DabeerAzeez/Team22-5P06-Capstone/src/assets/check-circle.png

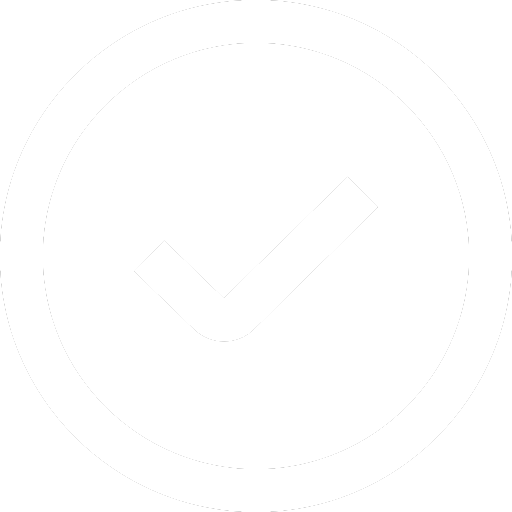
src/assets/check-circle.png
