DabeerAzeez/Team22-5P06-Capstone/src/assets/eraser_white.png

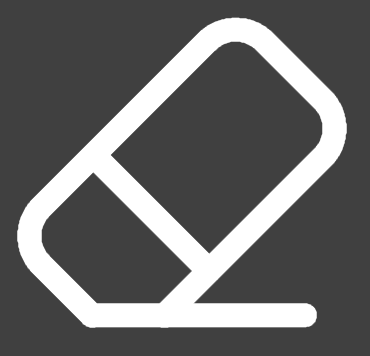
src/assets/eraser_white.png
