DabeerAzeez/Team22-5P06-Capstone/src/assets/export.png

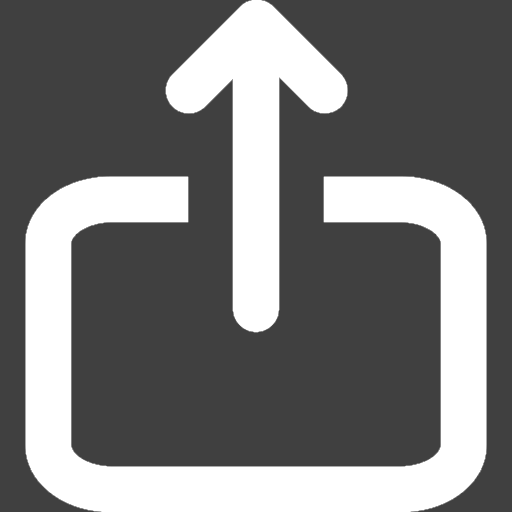
src/assets/export.png
