DabeerAzeez/Team22-5P06-Capstone/src/assets/play-button-arrowhead.png

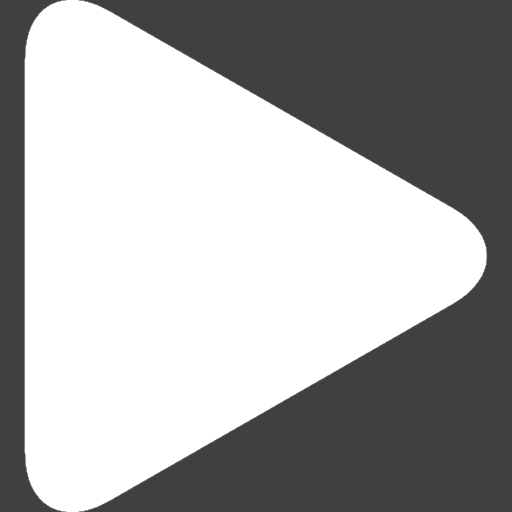
src/assets/play-button-arrowhead.png
