DabeerAzeez/Team22-5P06-Capstone/docs/CCTA BOM.xlsx

Part Number | Description | Type | Quantity | Unit | Material | Supplier | Cost per Unit (CAD) | Total Cost (CAD) | Source | Notes
1 | 12V Diaphragm Water Pump | Mechanical | 1 | Each | Misc. | Bayite | 64.68 | 64.68 | Link (https://www.amazon.ca/gp/product/B07V9G4S41?ie=UTF8&psc=1)
2 | Kohree RV Water Pressure Regulator Valve | Mechanical | 1 | Each | Brass | Amazon | 39.99 | 39.99 | Link (https://www.amazon.ca/dp/B08TGQP7ZX?ref=ppx_yo2ov_dt_b_fed_asin_title&th=1)
3 | 3/8 NPTF Female Needle Valve | Mechanical | 1 | Each | Brass | McMaster Carr | 85.49 | 85.49 | Link (https://www.mcmaster.com/46425K13/)
4 | Right Atrium | Mechanical | 1 | Each | Resin | Boston Scientific | 0 | 0 |  | Price Unknown
5 | Left Atrium | Mechanical | 1 | Each | Resin | Boston Scientific | 0 | 0 |  | Price Unknown
6 | Heart Base | Mechanical | 1 | Each | Resin | Boston Scientific | 0 | 0 |  | Price Unknown
7 | 3/8" GREDIA Quick Connect Water Flow Sensor Food-Grade | Electrical | 2 | Each | Food Grade Plastic | Amazon | 14.99 | 29.98 | Link (https://www.amazon.ca/GREDIA-Food-Grade-Flowmeter-Counter-0-3-10L/dp/B07MY7H45V)
8 | Pressure Transducer | Electrical | 3 | Each | Misc. | Utah Medical | 15.86 | 47.58 | Link (http://www.utahmed.com/deltran.html)
9 | Continuous-Flex Soft Tygon PVC Tubing (3/8" ID) | Mechanical | 25 | ft | PVC Plastic | McMaster Carr | 4.36 | 109 | Link (https://www.mcmaster.com/5894K37/)
10 | Continuous-Flex Soft Tygon PVC Tubing (1/4" ID) | Mechanical | 2 | ft | PVC Plastic | McMaster Carr | 7.4 | 14.8 | Link (https://www.mcmaster.com/55485K74/)
11 | Rigid PVC Tubing (3/8" ID) | Mechanical | 25 | ft | PVC Plastic | McMaster Carr | 1.22 | 30.5 | Link (https://www.mcmaster.com/5233K65/)
12 | Reservoir | Mechanical | 1 | Each | Plastic | Dollarama | 2 | 2 | Link (https://dollarama.instacart.com/store/dollarama/products/25063811-snaptite-food-container-each)
13 | DC Power Supply Variable,30V 10A | Electrical | 1 | Each | Misc. | Sky Toppower | 76 | 76 | Link (https://www.amazon.ca/Adjustable-Switching-Regulated-Alligator-Spectrophotometer/dp/B07GCKHKC6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)
14 | Tuohy valve | Mechanical | 1 | Each | PC Silicone | Qosina | 18.98 | 18.98 | Link (https://www.qosina.com/tuohy-borst-adapter-barbed-11224?VariantID=Version_v-01)
15 | 3/8" NPT to 3/8" Barb | Mechanical | 2 | Each | Brass | McMaster Carr | 3.16 | 6.32 | Link (https://www.mcmaster.com/5346K19/)
16 | Garden Hose to 3/8" Barbed Fitting | Mechanical | 1 | Each | Brass | Amazon | 26.01 | 26.01 | Link (https://www.amazon.ca/dp/B0BX32C2GM?ref=ppx_yo2ov_dt_b_fed_asin_title&th=1)
17 | Barbed T Connector (3/8" to 1/4") | Mechanical | 3 | Each | PP Plastic | Qosina | 1.66 | 4.98 | Link (https://www.qosina.com/t-connector-reducer-barbed-natural-61204-1?VariantID=Version_v-01)
18 | Barbed y connector (3/8") | Mechanical | 2 | Each | PP Plastic | Qosina | 2.15 | 4.3 | Link (https://www.qosina.com/y-connector-barbed-natural-61310-3?VariantID=Version_v-01)
19 | 3/8" Hose ID Barb Thru-Bulk Bulkhead Fittings | Mechanical | 1 | Pack | Plastic | Patikil | 15.24 | 15.24 | Link (https://www.amazon.ca/PATIKIL-Thru-Bulk-Bulkhead-Fittings-Silicone/dp/B0DKCQTFPZ?th=1)
20 | Plastic Bottling Bucket Spigot tap Faucet | Mechanical | 1 | Pack | Plastic | Pera Store | 8 | 8 | Link (https://www.amazon.ca/Plastic-Bottling-Bucket-Spigot-Homebrew/dp/B0746GXTV1)
21 | Peg Board | Mechanical | 1 | Each | Wood | Home Depot | 16.94 | 16.94 | Link (https://www.homedepot.ca/product/alexandria-moulding-3-16-inch-x-24-inch-x-48-inch-pegboard-white-handy-panel/1000165172)
22 | Zip Ties | Mechanical | 1 | Pack | Plastic | Home Depot | 7.47 | 7.47 | Link (https://www.homedepot.ca/product/commercial-electric-8-inch-cable-ties-indoor-use-nylon-material-white-100-pack-/1000762523)
23 | Hose Clamps | Mechanical | 1 | Pack | Stainless Steel | Ouru | 20.99 | 20.99 | Link (https://www.amazon.ca/OURU-Stainless-Automotive-Mechanical-Applications/dp/B09ZQTSZ5L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)
24 | Female Luer Lock, Barbed 1/4" | Mechanical | 4 | Each | Nylon | Qosina | 0.241 | 0.964 | Link (https://www.qosina.com/female-luer-lock-barbed-white-11530?VariantID=Version_v-01)
25 | One way stopcock | Mechanical | 10 | Each | HDPE | Qosina | 1.36 | 13.6 | Link (https://www.qosina.com/female-luer-lock-barbed-white-11530?VariantID=Version_v-01)
26 | Control box | Mechanical | 1 | Each | Plastic | McMaster | 0 | 0 |  | 3D Printed
27 | Arduino | Electrical | 1 | Each | Misc. | Arduino | 45.92 | 45.92 | Link (https://store.arduino.cc/products/arduino-uno-rev3)
28 | Motor driver | Electrical | 1 | Pack | Misc. | Reland Sun | 27 | 27 | Link (https://www.amazon.ca/BTS7960-Power-Driver-Module-Current/dp/B0CRP2BMRJ?s=electronics)
29 | Solder-able Prototype Breadboard | Electrical | 1 | Each | Misc. | Gikfun | 15.8 | 15.8 | Link (https://www.amazon.ca/Gikfun-Solder-able-Breadboard-Arduino-Electronic/dp/B0778G64QZ?s=electronics)
30 | 5mm LED | Electrical | 1 | Pack | Misc. | Adafruit Industries | 8.43 | 8.43 | Link (https://www.amazon.ca/Gikfun-Assorted-Arduino-100pcs-EK8437/dp/B01ER728F6?s=electronics)
31 | Aviator Connectors | Electrical | 1 | Pack | Misc. | Hilitchi | 31.63 | 31.63 | Link (https://www.amazon.com/dp/B07F5B5LLX?th=1&language=en_US&currency=CAD)
32 | Banana Plugs | Electrical | 1 | Pack | Misc. | Walfront | 13.54 | 13.54 | Link (https://www.amazon.com/Amplifier-Terminal-Connector-Binding-Banana/dp/B07H699FQV)
33 | 22AWG Wire | Electrical | 1 | Spool | Misc. | Dkardu | 12.42 | 12.42 | Link (https://www.amazon.ca/DKARDU-Electrical-Conductor-Stranded-Flexible/dp/B09PH3DNTV?th=1)
34 | E stop | Electrical | 1 | Each | Misc. | RuoFend | 12 | 12 | Link (https://www.amazon.ca/RuoFeng-Mushroom-Emergency-Button-Switch/dp/B07HBN45Q9)
35 | USB printer cable | Electrical | 1 | Each | Misc. | Moswag | 9.59 | 9.59 | Link (https://www.amazon.ca/MOSWAG-Printer-Durable-Lexmark-Brother/dp/B08ZD279K2)
36 | M3-0.5x10mm socket cap screw (3-Pieces) | Mechanical | 4 | Each | Stainless Steel | Home Depot | 0.5625 | 2.25 | Link (https://www.homedepot.com/p/Everbilt-M3-0-5x10mm-Plain-Socket-Cap-Head-Internal-Hex-Drive-Cap-Screw-3-Pieces-864518/323372100)
37 | M2.5 x 0.45 mm Thread, 8 mm Long (50 Pack) | Mechanical | 50 | Each | Alloy Steel | McMaster Carr | 0.32 | 16 | Link (https://www.mcmaster.com/91290A102/)
38 | Heat inserts | Mechanical | 20 | Each | Brass | Spool3D | 0.15 | 3 | Link (https://spool3d.ca/m3-knurled-brass-threaded-insert/)
