DabeerAzeez/Team22-5P06-Capstone/docs/CCTA Operation Manual.docx

# CCTA Operation Manual

# Equipment Needed

Item | Purpose
CCTA Physical System
Laptop with MATLAB r2023a or later installed | To operate the CCTA
CCTA MATLAB App | To control the CCTA
Syringe with male luer lock fitting | Debubble pressure transducers for pressure testing

# Software Installation

1. Clone or download the GitHub repository
  a. Cloning is ideal, so that you can stay up to date with any future changes. You can use GitHub desktop to do so, or just Git. Otherwise, just download the files onto your computer.
2. Install MATLAB R2023b or later (https://www.mathworks.com/help/install/ug/install-products-with-internet-connection.html)
3. Install the Arduino IDE (https://www.arduino.cc/en/software/)
4. (Optional) open src/CCTA_Arduino/CCTA_Arduino.ino and re-upload the script onto the Arduino board.
  a. Important to do especially after any changes to the Arduino script.
5. Open src/CCTA.mlapp
  a. This will open MATLAB itself (which you can minimize, but do not close)
  b. As well as the actual application (a smaller window as seen below)

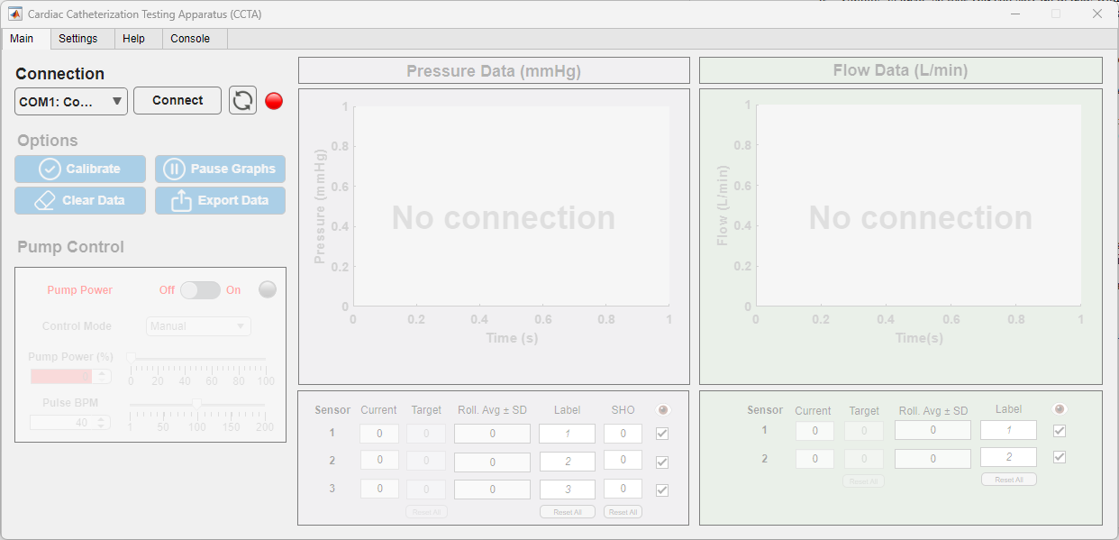
[picture p23: figure]

# System Operational Procedure

1. Set up the flow system
  a. Connect the pump inlet and outlet with 3/8” tubing
  b. Position system components (i.e. tubing, connectors, valves, heart model, flow meter(s), and pressure transducer(s)) at the desired test point locations within the system
  c. Fill reservoir with water (e.g. use a separate bucket and fill it up at a sink)
1. Set up the control box
  a. Connect the flow meter connectors to the ports on the control box:

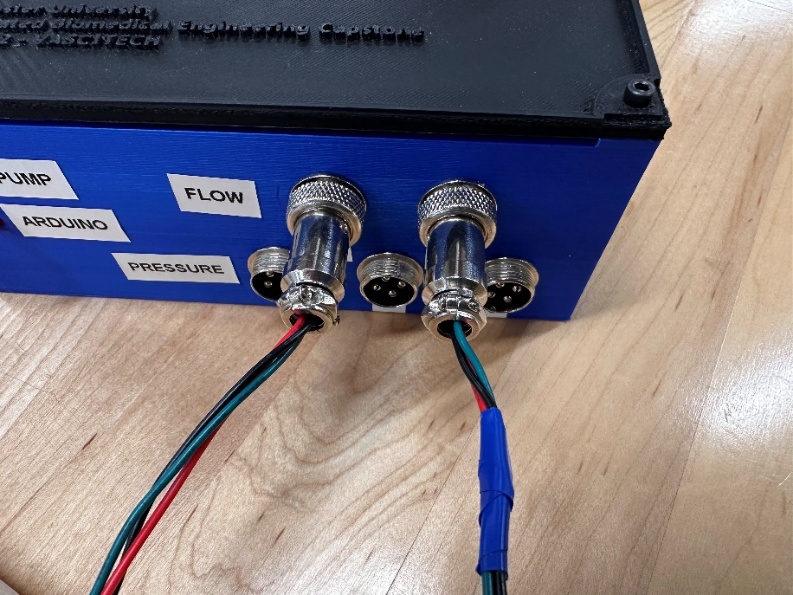
[picture p24: figure]

  b. Connect the pressure meter connectors to the ports on the control box:

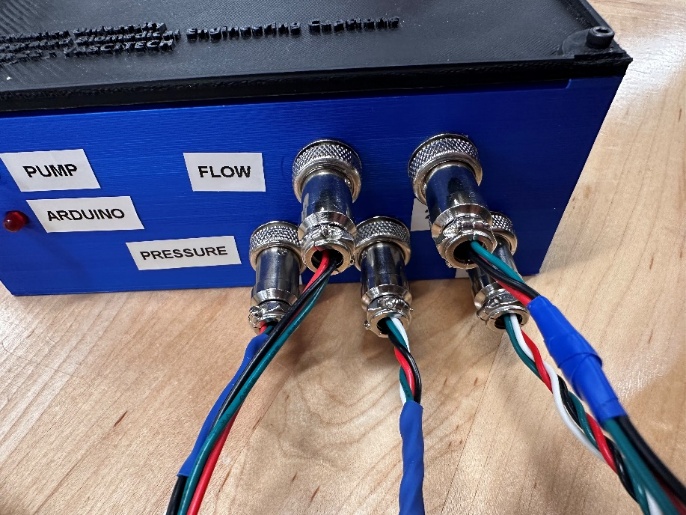
[picture p25: figure]

  c. Connect banana plugs between the power supply and the control box:

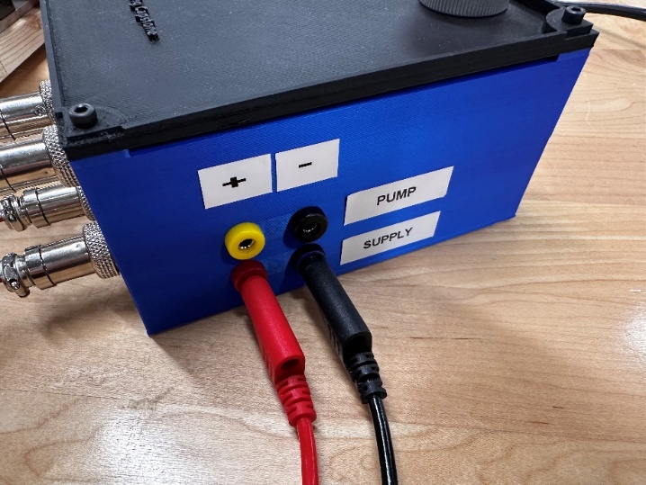
[picture p26: figure]

  d. Connect banana plugs between the control box and the pump:

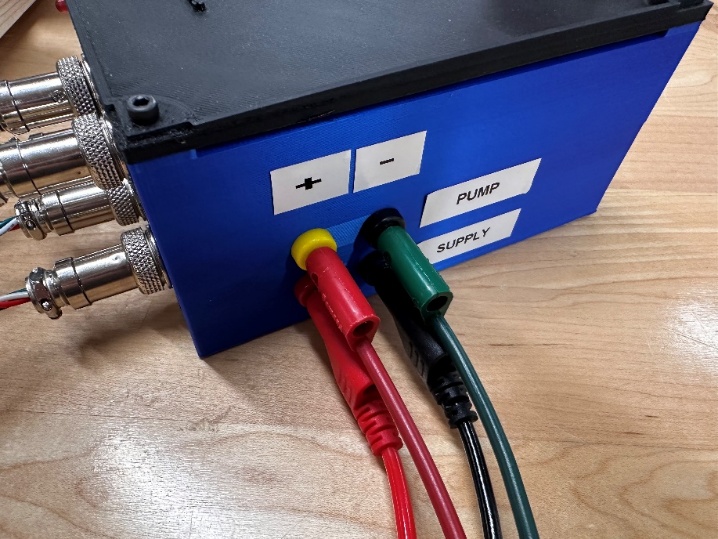
[picture p27: figure]

  e. Connect the user’s computer to the USB port on the control box and ensure the red LED on the control box lights to indicate successful connection:

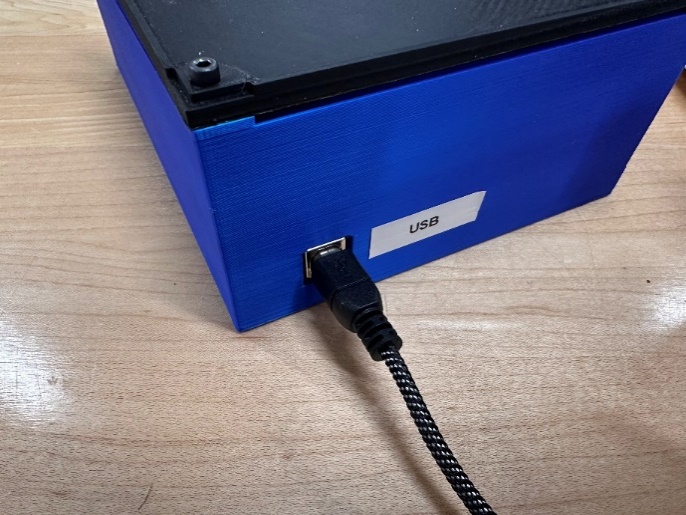
[picture p28: figure]

2. Start the system
  a. Turn on the power supply, set to 12 V and a 3.3 A
  b. Run the GUI in MATLAB (i.e. run the CCTA.mlapp file using MATLAB) and connect to the appropriate COM port (it should say “Arduino Uno” in the dropdown)
3. Test basic functionality of the GUI
  a. Confirm that baseline flow and pressure are being reported in the GUI (in the textboxes as well as the graphs)
    i. When the pump is off, flow values should be 0 and pressure values should be low (around 8-10 mmHg, corresponding to the static head offset in the system)
  b. After confirming basic GUI functionality and enabling pump power, you can select the Control Mode from the dropdown menu in the GUI. The system provides three modes:
    i. Manual (default)
    ii. Auto
    iii. Pulsatile

Use the dropdown menu (see below) to switch between modes as needed for your experiment:

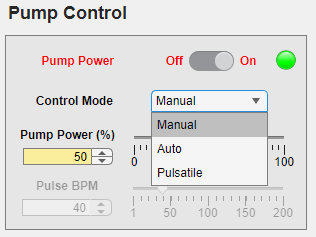
[picture p29: figure]

  4.1 Manual Mode (Default)

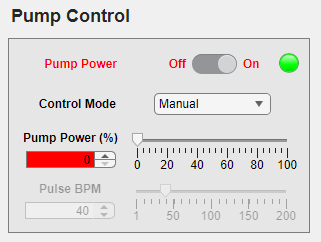
[picture p30: figure]

    - Enable pump power by toggling the slider to On.
    - Ensure the system is operating in Manual Mode (check the Control Mode dropdown).
    - Set an initial Pump Power (%) value (recommended to start at 50%) to confirm proper system function.
    - Confirm the blue LED on the control box lights up, indicating the pump is receiving power.
    - Adjust the Pump Power (%) slider or input box manually to increase or decrease the pump speed.
    - Verify that changes in pump power result in appropriate changes in flow rate and pressure on the GUI.
    - Confirm that other GUI elements behave as expected (hover over buttons for descriptions).
  4.2 Auto Mode

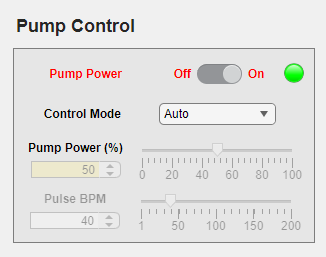
[picture p31: figure]

In Auto Mode, the system automatically adjusts pump power to maintain a specified target flow or pressure using PID control.
Steps to operate in Auto Mode:

- DO NOT select Auto Mode from the Control Mode dropdown (this will not work).
- Instead, enter your desired Target value in the box corresponding to a specific flow or pressure sensor.
- Press Enter to confirm. The Target box just chosen will highlight green, and the pump power slider and spinner will be slightly greyed out, indicating the system has accepted the target and is actively adjusting pump power.

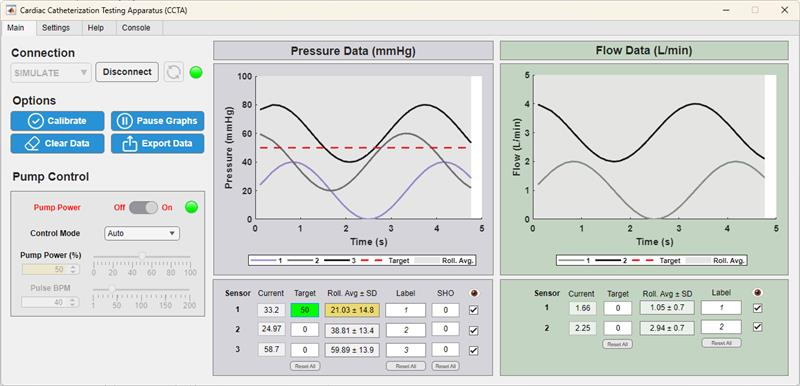
[picture p32: figure]

- Observe the Pump Power (%) value changing automatically as the system adjusts to reach the target.
- Wait for the system to stabilize at the setpoint before beginning any measurements or catheter testing.
  4.3 Pulsatile Mode

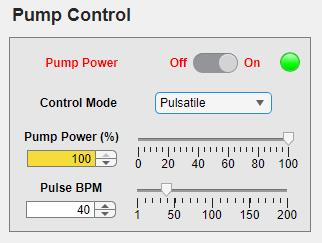
[picture p33: figure]

In Pulsatile Mode, the pump output follows a simple sinusoidal waveform designed to mimic physiological flow conditions, such as a heartbeat. This mode allows you to adjust two key parameters:

- Pump Power (%): Controls the amplitude of the pulses (i.e., the peak pump power during each pulse). Higher values increase the pulse strength.
- Pulse BPM (Beats Per Minute): Sets the frequency of the pulsatile waveform, determining how many pulses occur per minute.

Steps to operate in Pulsatile Mode:

- Select Pulsatile Mode from the Control Mode dropdown.
- Set the Pump Power (%) to determine the amplitude of each pulse (default 100%).
- Set the Pulse BPM value to define the pulse frequency (default 40 BPM).
- Observe the flow and pressure waveforms reflecting the pulsatile output in real-time on the GUI graphs.
- Adjust Pump Power (%) and Pulse BPM as needed to simulate desired physiological conditions.
4. Catheter testing (Flow Simulation)
  a. Open the needle valve to the silver line (fully open).

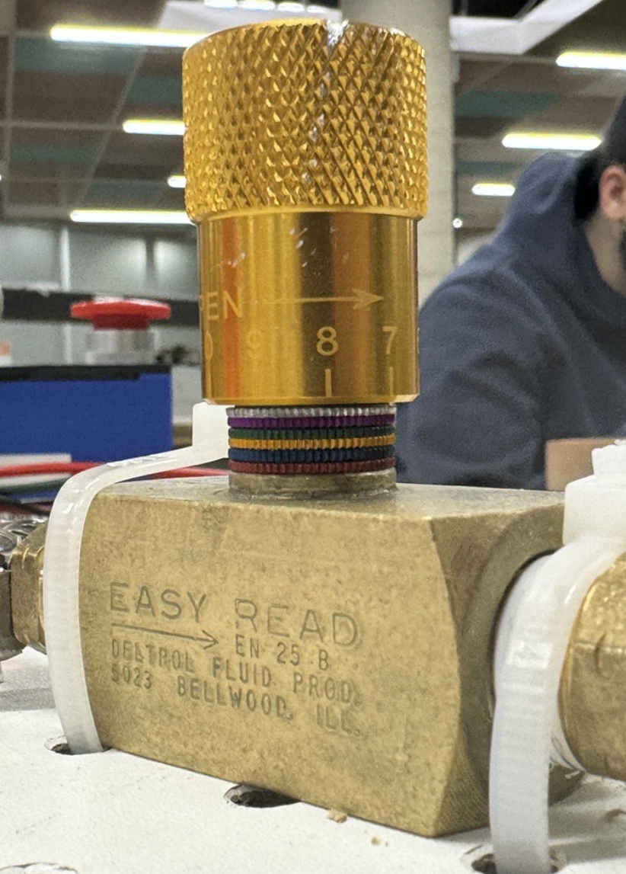
[picture p34: figure]

Silver Line

  b. Enter a setpoint value for one of the flow sensors to begin PID control, depending on the desired parameter to be controlled. Press enter to confirm your target value, and the appropriate target box should highlight green:

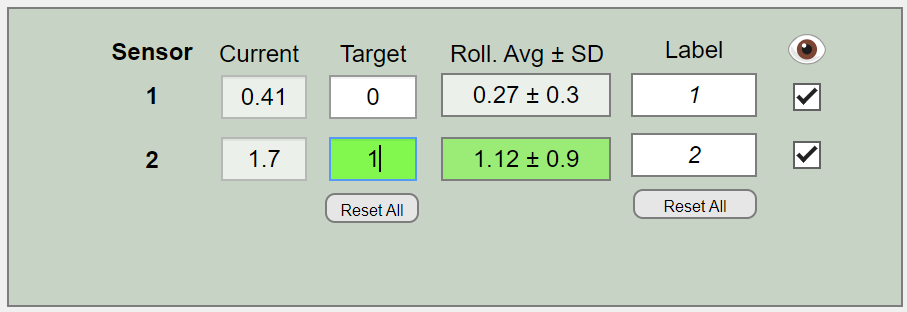
[picture p35: figure]

  c. Verify that the “Pump Power (%)” is changing appropriately based on the error between the current value and the target value (i.e. is the pump increasing/decreasing power appropriately to reach its target)
  d. Wait for the system to stabilize to the setpoint
  e. Begin catheter testing
5. Catheter testing (Pressure Simulation)
  a. Open the needle valve to the silver line (fully open).

Silver Line

  b. Set the Pump Power to 50%.
  c. Debubble each pressure sensor using a syringe.
    i. Push bubbles by squeezing the flexible tubing.
  d. Calibrate the pressure sensors to remove the Static Head Offset (SHO) by clicking “Calibrate” on the MATLAB App.

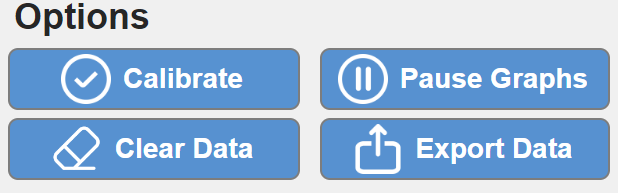
[picture p36: figure]

    i. Follow all steps listed on the GUI
  e. Adjust the needle valve slowly until the pressure gauge reads your target value:
    i. While you turn the needle valve, watch the regulator’s analog gauge—any movement of its pointer means the regulator is active and smoothing out pressure spikes.
    ii. Make sure the gauge never exceeds 30 PSI.
