DabeerAzeez/Team22-5P06-Capstone/docs/CCTA Verification Tests/Test 06 - Flow Sensor Calibration/Flow Testing CCTA 2025-03-07.xlsx

Sensor | Voltage | Flow (Arduino, L/min) | Flow (actual, L/s) | Flow (actual, L/min)
2 | 3 | 0.360 | 0.018 | 1.084
2 | 4 | 1.290 | 0.029 | 1.765
2 | 5 | 2.090 | 0.042 | 2.500
2 | 6 | 2.740 | 0.048 | 2.903
2 | 7 | 3.220 | 0.056 | 3.358
1 | 3 | 0.570 | 0.018 | 1.084
1 | 4 | 1.290 | 0.028 | 1.667
1 | 5 | 2.220 | 0.039 | 2.368
1 | 6 | 2.860 | 0.049 | 2.924
1 | 7 | 3.310 | 0.056 | 3.333
 |  |  |  | 0.000
 |  |  |  | 0.000
 |  |  |  | 0.000
