DabeerAzeez/Team22-5P06-Capstone/docs/CCTA Verification Tests/Test 08 - Amplified Pressure Sensor Calibration/Pressure Sensor CC.xlsx

Pressure (mmHg) | Voltage (V)
0 | 0.071
25.2 | 0.714
49.8 | 1.4
75.4 | 2.07
99.4 | 2.64
124.6 | 3.13
150 | 3.13
