DabeerAzeez/Team22-5P06-Capstone/(commit log)

2024-11-14 Add flow/pressure testing code and move code into subfolders
2025-02-06 Update pressure sensor and flow sensor values at different times
2025-02-11 Major update to PressureFlowReading.ino
2025-02-14 Update printSensorValues to include all sensors properly
2025-02-28 Update Arduino script to hold different calibration curves for each pressure sensor
2025-03-03 Add preliminary Arduino motor control functions
2025-03-05 Add refresh serial connections button, add preliminary stepper motor control, and add serial communications between GUI and Arduino for motor control
2025-03-06 Update GUI to look nicer, add preliminary code to send/receive pump duty cycle to Arduino
2025-03-07 Add custom label fields for graphing/exporting data, and disable export button while exporting data
2025-03-07 Added calibration curves for flow sensors
2025-03-10 Add pump control test sketch
2025-03-10 Add preliminary PID control features in GUI, send motor value along with sensor values over serial from Arduino
2025-03-12 Improve serial communication speed and ability to send values and forth for PID control
2025-03-12 Speed up Arduino RX by using SerialEvent to process incoming messages
2025-03-12 Add constants at top of Arduino script to select simulation parameters
2025-03-12 Fix front-end switching between Manual / Auto control of PID values
2025-03-14 Disable/enable components on startup properly, add some button icons and better button colors
2025-03-18 Major UI updates to improve responsiveness
    [ExportedData.csv]
2025-03-19 Remove data from Data folder
    [ExportedData.csv]
2025-03-19 Various frontend updates, static head offset calibration, preliminary pulsatile flow code, help menu, tooltips
2025-03-23 Add static head offset and calibration procedure
2025-03-25 Update calibration procedure to disable UI components, not block UI, and add calibration duration edit field in settings, remove some more pressure valve code
2025-03-26 Remove more pressure motor code, rearrange UI for clarity, add average/SD readings for flow/pressure, add icon to calibrate button
2025-03-26 Improve UI responsivity and consistency when connecting/disconnecting, add reset buttons for target/label/SHO values
2025-03-28 Add calibration curve for third pressure sensor and add some comments to interpolatePressure() in Arduino file
2025-03-28 Various frontend updates, fix calibration procedure workflow, refactor arduino command code into setPumpPower() function
2025-03-28 Update CCTA_Arduino.ino
    Updated Calibration Data
2025-04-05 Refactor and comment Arduino code
2025-04-12 Add pulsatile flow, some uialerts, and stop re-making graph legends each time unless needed
2025-04-15 Implement pulsatile flow in GUI and improve serial communication handling in MATLAB and Arduino
2025-04-16 Move PID control to Arduino, add debug console in GUI, and improve user-facing GUI error handling
    [CCTA_Arduino.ino]
2025-04-18 Change the PID time interval on Arduino based on the PID setpoint ID
2025-04-20 Send PID config to Arduino whenever PID coefficients are changed
2025-04-20 Add markers to flow curves to highlight new flow values; also update simulated data values to be non-constant
2025-04-20 Clear flow marker arrays on clear data button press
2025-04-21 Fix newFlow plotting errors, sendPIDConfigToArduino(), flowTargetLine not showing,
2025-04-21 Use different PID history array lengths for pressure/flow control
2025-04-22 Make reset target buttons and target edit fields disabled when pump power is turned
2025-04-22 Remove "new flow" markers from plots
2025-04-24 Update CCTA_Arduino.ino to use new flow sensor with preliminary calibration curve
2025-04-24 Keep track of SHO values in Arduino (preliminary attempt)
2025-04-24 Use integers only instead of longs for serial commands received by Arduino, change serial scaling factor to 100, add limits to target values in GUI to help enforce precision limits
    System faced memory allocation issues, it seems, when longs were used. It was weird and hard to debug. Sticking with integers was better, though you have to sacrifice on precision. Changed serial scaling factor to 100, which gives max values of 327.67 (2 decimals precision) which can be sent to the Arduino. Plenty, considering the types of values that the GUI will send.
    [CCTA_Arduino.ino]
2025-04-24 Upload docs/ folder with all reports, with numbering modified to match the system report
    [CCTA BOM.xlsx, Flow Testing CCTA 2025-03-07.xlsx, Pressure Calibration Curve.xlsx, Pressure Sensor CC.xlsx, System Capabilities Test Data.xlsx]
2025-04-25 Turn pump power UI off properly when disconnecting, add more tooltips, and fix ability to change graph labels
2025-04-25 Update documentation and README
    [CCTA BOM.xlsx]
2025-04-28 Update README.md
    Added CAD Dropbox link
